Chloxeo/SCALAR-7_CanSat/hardware/Lib_VIF_ELAN/3D/CON_UFL001-SMD-T.stp

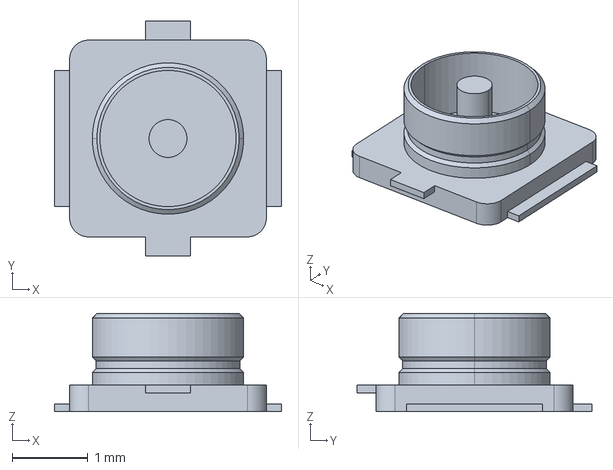
[picture p2: CAD file, 2026-10-30]
hardware/Lib_VIF_ELAN/3D/CON_UFL001-SMD-T.stp
3.00 x 3.10 x 1.30 mm
