Chloxeo/SCALAR-7_CanSat/hardware/Lib_VIF_ELAN/3D/SMA_coude.stp

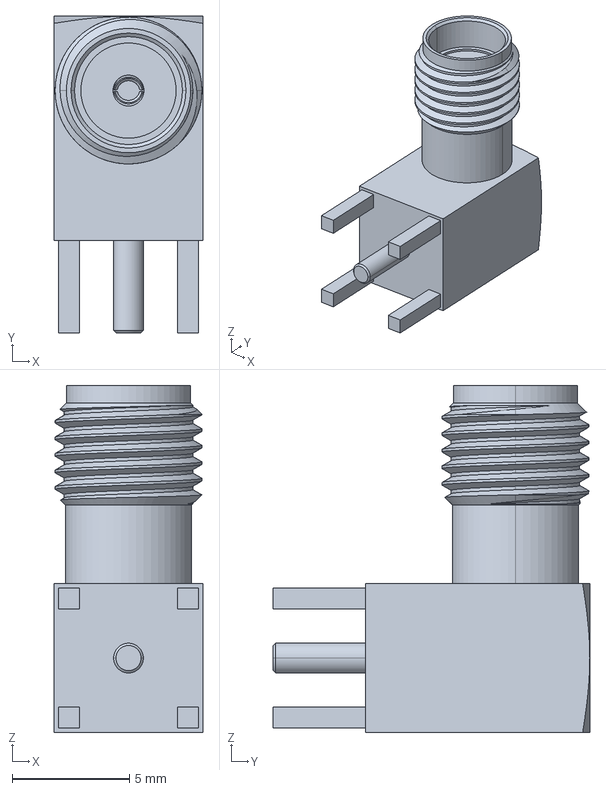
[picture p3: CAD file, 2026-10-30]
hardware/Lib_VIF_ELAN/3D/SMA_coude.stp
6.35 x 13.5 x 14.8 mm
