Chloxeo/SCALAR-7_CanSat/hardware/Lib_VIF_ELAN/3D/pile btn.stp

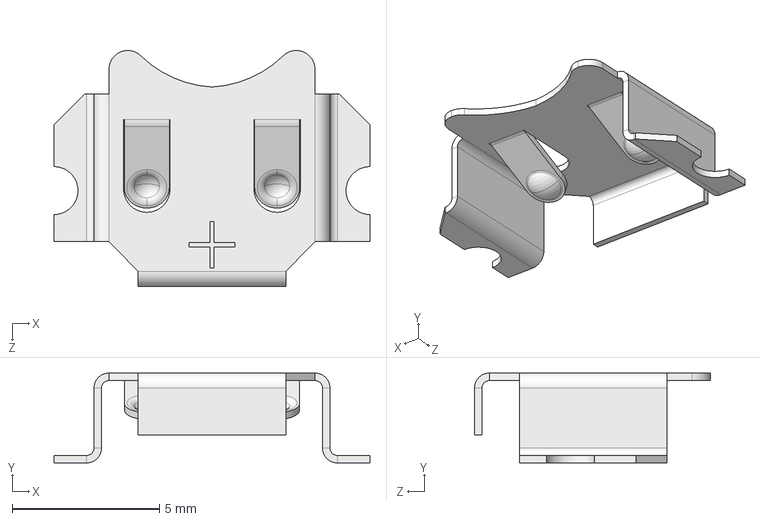
[picture p4: CAD file, 2026-10-30]
hardware/Lib_VIF_ELAN/3D/pile btn.stp
10.7 x 3.05 x 8.00 mm
