Chloxeo/SCALAR-7_CanSat/hardware/Lib_VIF_ELAN/3D/CEM-1206S.STEP

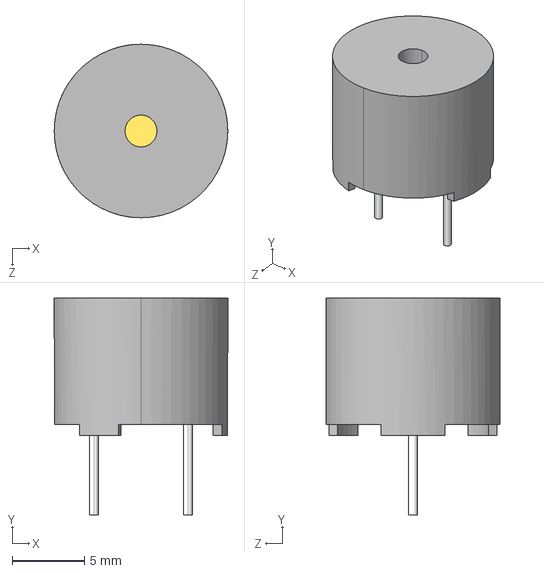
[picture p6: CAD file, 2026-10-30]
hardware/Lib_VIF_ELAN/3D/CEM-1206S.STEP
12.0 x 15.0 x 12.0 mm
