Chloxeo/SCALAR-7_CanSat/hardware/Lib_VIF_ELAN/3D/22-05-3041.stp

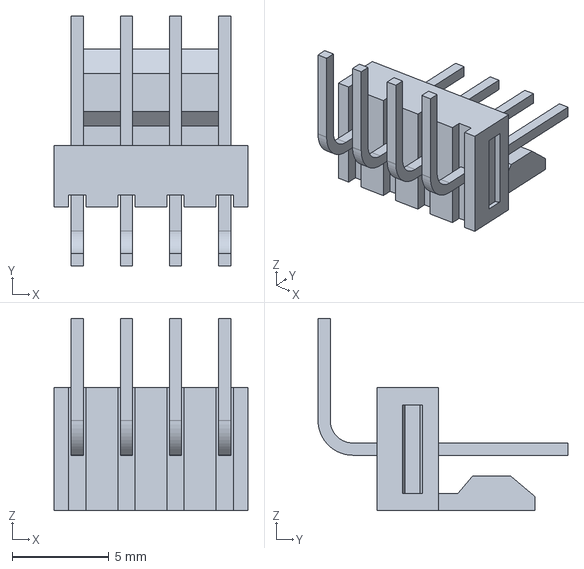
[picture p7: CAD file, 2026-10-30]
hardware/Lib_VIF_ELAN/3D/22-05-3041.stp
10.0 x 12.9 x 9.93 mm
