Chloxeo/SCALAR-7_CanSat/hardware/Lib_VIF_ELAN/3D/USB4085-GF-A.stp

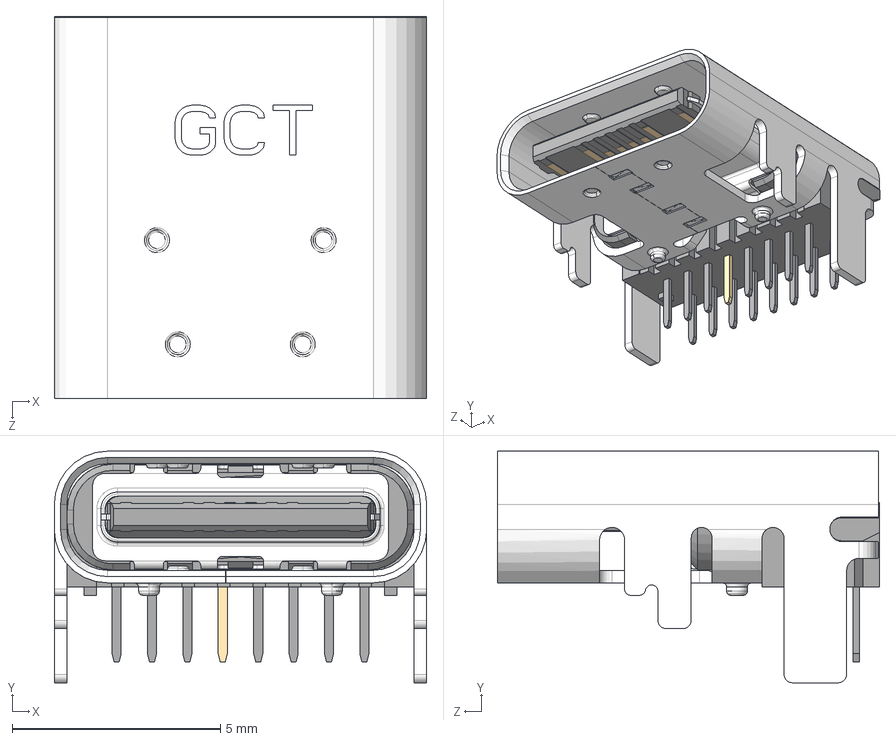
[picture p9: CAD file, 2026-10-30]
hardware/Lib_VIF_ELAN/3D/USB4085-GF-A.stp
8.94 x 5.56 x 9.17 mm
USB4085-GF-A_PART3
USB4085-GF-A_PART2
USB4085-GF-A_PART1
