Chloxeo/SCALAR-7_CanSat/hardware/Lib_VIF_ELAN/3D/KP466PXTMA1.stp

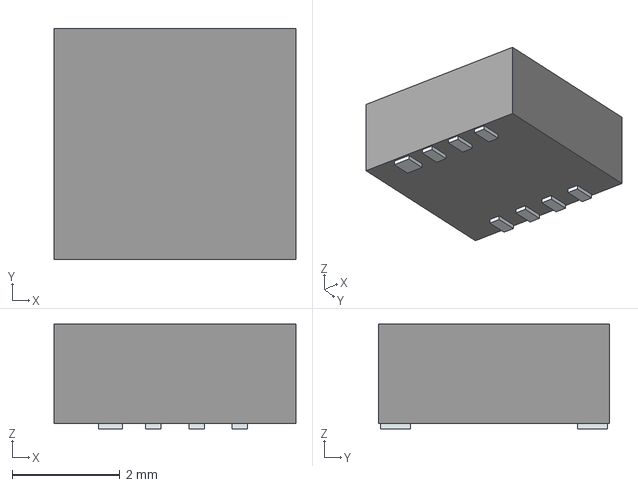
[picture p10: CAD file, 2026-10-30]
hardware/Lib_VIF_ELAN/3D/KP466PXTMA1.stp
4.50 x 4.30 x 1.95 mm
Pins
