Chloxeo/SCALAR-7_CanSat/hardware/Lib_VIF_ELAN/3D/RFM95W-868S2.stp

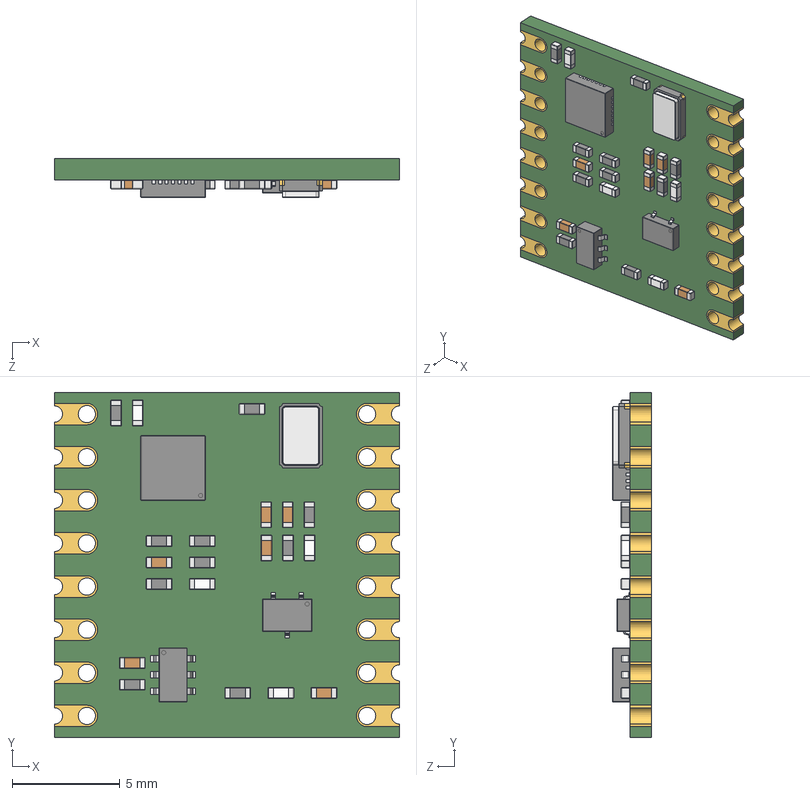
[picture p11: CAD file, 2026-10-30]
hardware/Lib_VIF_ELAN/3D/RFM95W-868S2.stp
16.0 x 16.0 x 1.80 mm
Gold_3
Gold_5
Gold_12
Gold_14
Gold_8
Gold_13
Gold
Gold_7
Gold_6
Gold_15
Gold_11
Gold_16
Gold_10
Gold_2
Gold_9
Gold_4
Passive Pins_22
Passive Pins_38
Passive Pins_30
Passive Pins_21
Passive Pins_10
Passive Pins_4
Passive Pins_35
Passive Pins_29
Passive Pins_28
Passive Pins
Passive Pins_32
Passive Pins_37
Passive Pins_40
Passive Pins_15
Passive Pins_31
Passive Pins_11
Passive Pins_13
Passive Pins_9
Passive Pins_7
Passive Pins_25
Passive Pins_16
Passive Pins_6
Passive Pins_19
Passive Pins_3
Passive Pins_23
Passive Pins_5
Passive Pins_17
Passive Pins_33
Passive Pins_39
Passive Pins_24
Passive Pins_12
Passive Pins_18
Passive Pins_8
Passive Pins_20
Passive Pins_2
Passive Pins_14
Passive Pins_26
Passive Pins_27
Passive Pins_36
Passive Pins_34
White Passive body_3
White Passive body_4
White Passive body_2
White Passive body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
