Chloxeo/SCALAR-7_CanSat/hardware/Lib_VIF_ELAN/3D/BAT54W-G3-18.stp

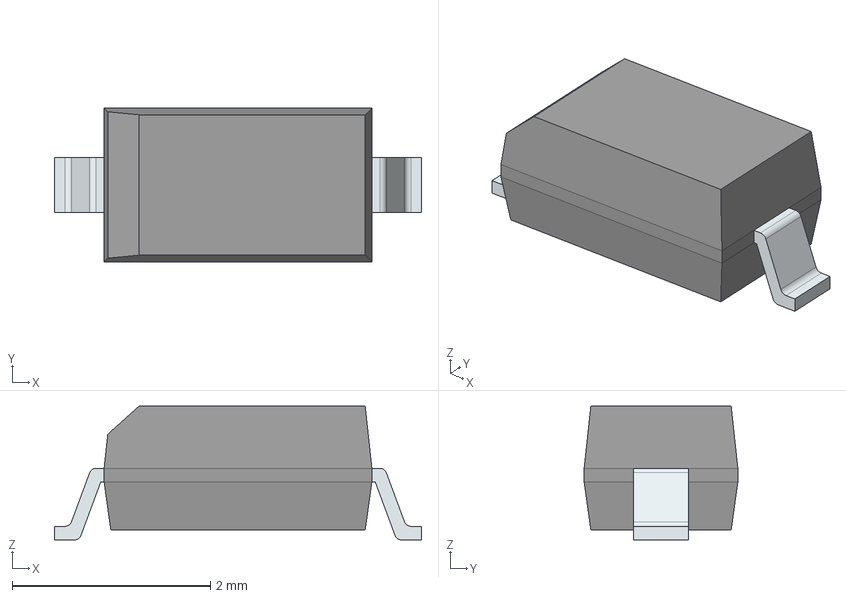
[picture p12: CAD file, 2026-10-30]
hardware/Lib_VIF_ELAN/3D/BAT54W-G3-18.stp
3.70 x 1.55 x 1.35 mm
FilletPinL
FilletPinR
