Chloxeo/SCALAR-7_CanSat/hardware/Lib_VIF_ELAN/3D/53048-0810.stp

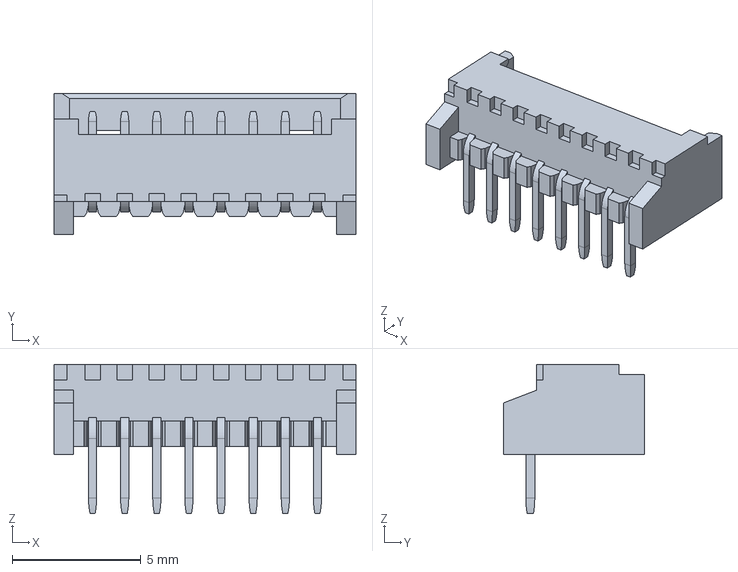
[picture p13: CAD file, 2026-10-30]
hardware/Lib_VIF_ELAN/3D/53048-0810.stp
11.8 x 5.50 x 5.80 mm
