Chloxeo/SCALAR-7_CanSat/schematic.pdf

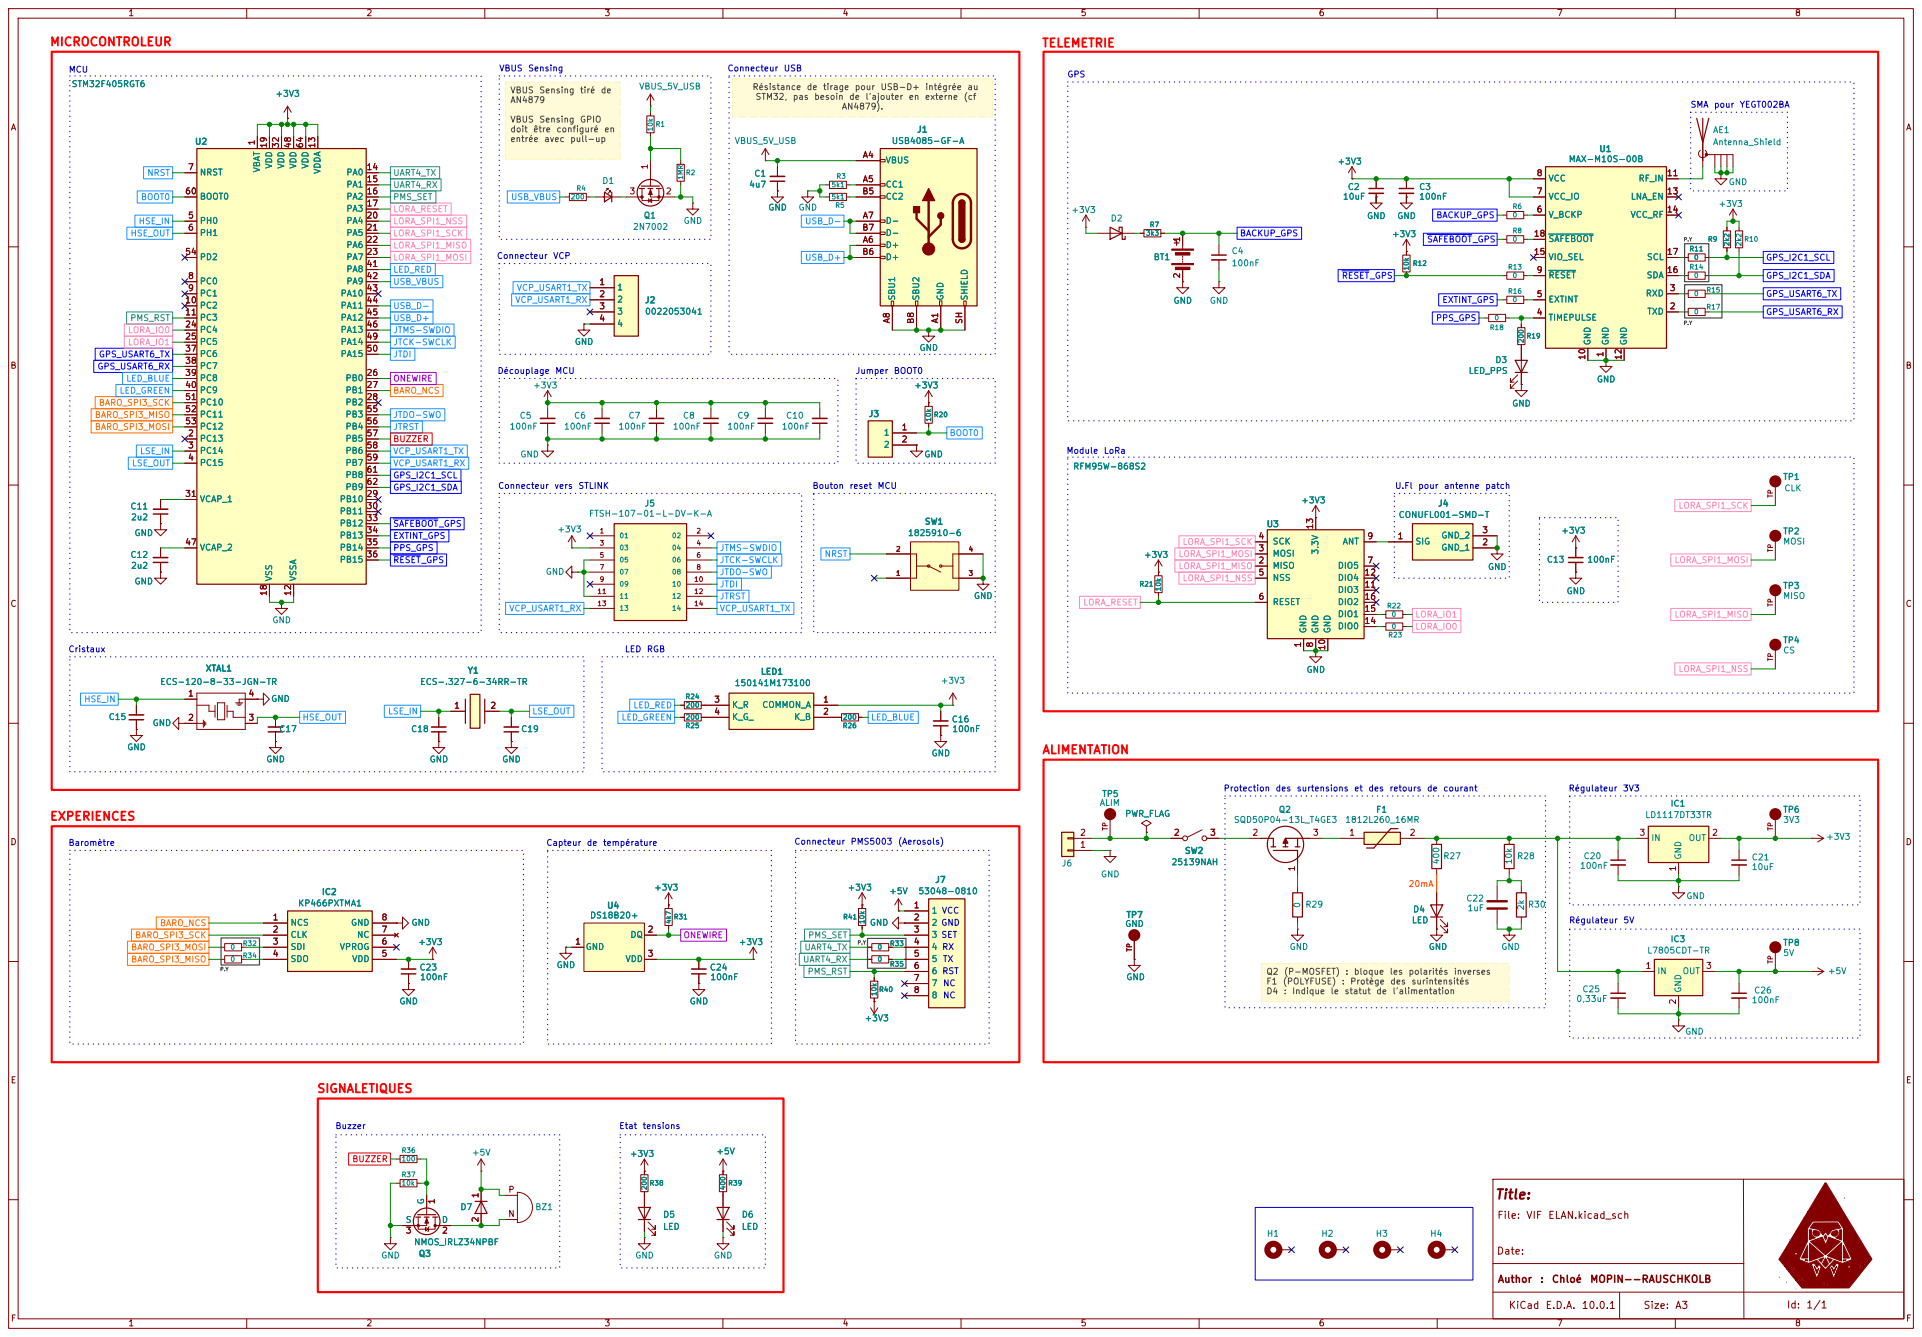
[picture p14: page 1]

Protection des surtensions et des retours de courant Découplage MCU MCU MICROCONTROLEUR

VBUS Sensing tiré de

Résistance de tirage pour USB-D+ intégrée au STM32, pas besoin de l'ajouter en externe (cf AN4879).

VBUS Sensing GPIO
doit être configuré en
entrée avec pull-up

Jumper BOOT0 Bouton reset MCU

Q2 (P-MOSFET) : bloque les polarités inverses F1 (POLYFUSE) : Protège des surintensités D4 : Indique le statut de l'alimentation

Author : Chloé MOPIN--RAUSCHKOLB
