Chloxeo/SCALAR-7_CanSat/hardware/VIF ELAN.kicad_pcb

## KiCad design hardware/VIF ELAN.kicad_pcb (2026-11-06)

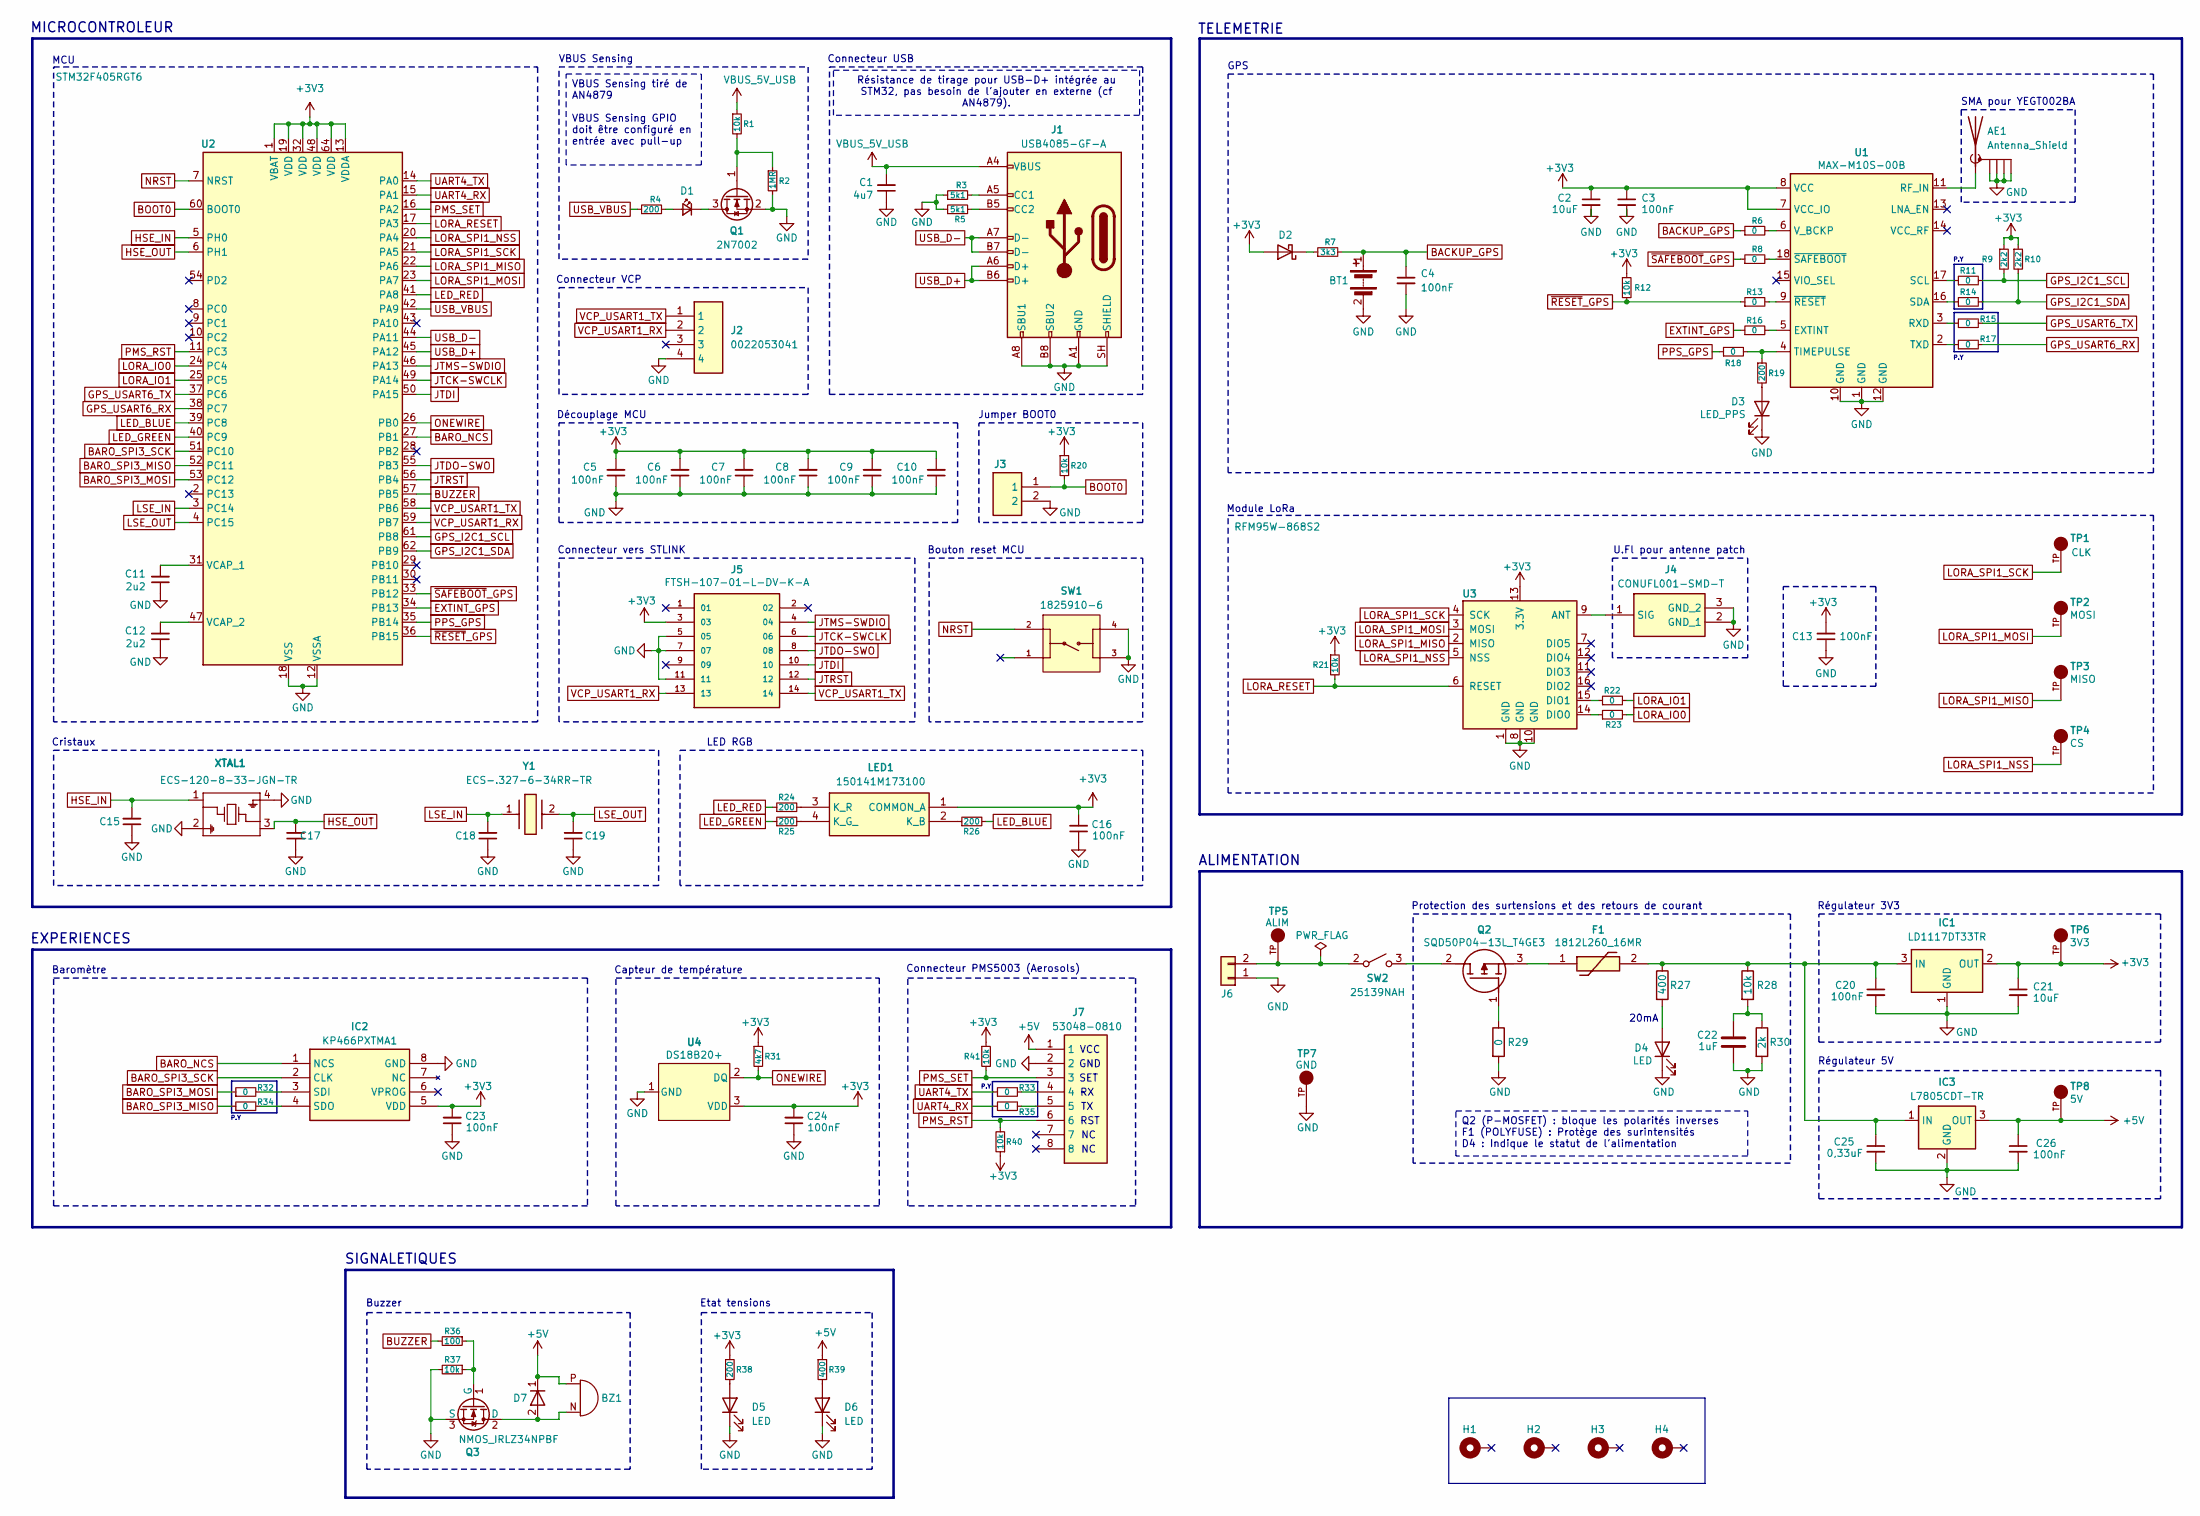
[picture p15: schematic VIF ELAN.kicad_sch]

Parts:
AE1: Antenna_Shield; SMA_coude
BT1: 6.8mm 3.3V; pile btn
BZ1: Buzzer; buzzer CUI_CEM-1206S
C1: 4u7; C_0603_1608Metric_Pad1.08x0.95mm_HandSolder
C2, C21: 10uF; C_0603_1608Metric_Pad1.08x0.95mm_HandSolder
C3, C4, C5, C6, C7, C8, C9, C10, C13, C16, C20, C23, C24, C26: 100nF; C_0603_1608Metric_Pad1.08x0.95mm_HandSolder
C11, C12: 2u2; C_0603_1608Metric_Pad1.08x0.95mm_HandSolder
C15, C17, C18, C19: C_0603_1608Metric_Pad1.08x0.95mm_HandSolder
C22: 1uF; C_0603_1608Metric_Pad1.08x0.95mm_HandSolder
C25: 0,33uF; C_0603_1608Metric_Pad1.08x0.95mm_HandSolder
D1, D4, D5, D6: LED; LED_0805_2012Metric_Pad1.15x1.40mm_HandSolder
D2: bat54 SOD3716X135N
D3: LED_PPS; LED_0805_2012Metric_Pad1.15x1.40mm_HandSolder
D7: D; D_0805_2012Metric_Pad1.15x1.40mm_HandSolder
F1: 1812L260_16MR; 1812L010DR; Mouser Part Number 576-1812L260/16MR
H1, H2, H3, H4: MountingHole_Pad; MountingHole_2.2mm_M2_DIN965_Pad_TopBottom
IC1: LD1117DT33TR; Mouser Part Number 511-LD1117DT33-TR
IC2: KP466PXTMA1; Mouser Part Number 726-KP466PXTMA1
IC3: L7805CDT-TR; L7805CDTTR; Mouser Part Number 511-L7805CDT-TR
J1: USB4085-GF-A; USB_C_Receptacle_GCT_USB4085; Manufacturer_Part_Number USB4085-GF-A
J2: 0022053041; 22053041; Manufacturer_Part_Number 0022053041; Mouser Part Number N/A
J3: TSW-102-07-G-S; jumper TSW-102-XX-YY-S; Manufacturer_Part_Number TSW-102-07-G-S; Mouser Part Number 200-TSW10207GS
J4: CONUFL001-SMD-T; CONUFL001SMDT; Mouser Part Number N/A
J5: FTSH-107-01-L-DV-K-A; FTSH-107-XX-YYY-DV-K-A; PARTREV H
J6: Batterie; SHDR2W100P0X508_1X2_1216X850X1215P
J7: 53048-0810; 530480810; Manufacturer_Part_Number 53048-0810; Mouser Part Number 538-53048-0810
LED1: 150141M173100; LED_RGB_Wuerth-PLCC4_3.2x2.8mm_150141M173100; Manufacturer_Part_Number 150141M173100; Mouser Part Number 710-150141M173100
Q1: 2N7002; SOT-23; Manufacturer_Part_Number DS18B20+
Q2: SQD50P04-13L_T4GE3; Q2 SQD50P0413L_T4GE3; Mouser Part Number 78-SQD50P04-13LT4GE3
Q3: NMOS_IRLZ34NPBF; TO-220-3_Horizontal_TabDown
R1, R12, R20, R21, R28, R37, R40, R41: 10k; R_0603_1608Metric_Pad0.98x0.95mm_HandSolder
R2: 1MR; R_0603_1608Metric_Pad0.98x0.95mm_HandSolder
R3, R5: 5k1; R_0603_1608Metric_Pad0.98x0.95mm_HandSolder
R4, R19, R24, R25, R26, R38: 200; R_0603_1608Metric_Pad0.98x0.95mm_HandSolder
R6, R8, R11, R13, R14, R15, R16, R17, R18, R22, R23, R29, R32, R33, R34, R35: 0; R_0603_1608Metric_Pad0.98x0.95mm_HandSolder
R7: 3k3; R_0603_1608Metric_Pad0.98x0.95mm_HandSolder
R9, R10: 2k2; R_0603_1608Metric_Pad0.98x0.95mm_HandSolder
R27, R39: 400; R_0603_1608Metric_Pad0.98x0.95mm_HandSolder
R30: 2k; R_0603_1608Metric_Pad0.98x0.95mm_HandSolder
R31: 4k7; R_0603_1608Metric_Pad0.98x0.95mm_HandSolder
R36: 100; R_0603_1608Metric_Pad0.98x0.95mm_HandSolder
SW1: 1825910-6; 18259106; PARTREV C10
SW2: 25139NAH
TP1: CLK; 5003; PARTREV B
TP2: MOSI; 5003; PARTREV B
TP3: MISO; 5003; PARTREV B
TP4: CS; 5003; PARTREV B
TP5: ALIM; 5003; PARTREV B
TP6: 3V3; 5003; PARTREV B
TP7: GND; 5003; PARTREV B
TP8: 5V; 5003; PARTREV B
U1: MAX-M10S-00B; ublox_MAX
U2: STM32F405RGT6; LQFP-64_10x10mm_P0.5mm; Manufacturer_Part_Number STM32F405RGT6
U3: RFM95W-868S2; HOPERF_RFM9XW_SMD; Manufacturer_Part_Number RFM95W-868S2
U4: DS18B20+; temp 21-0248A_MXM; Manufacturer_Part_Number DS18B20+
XTAL1: ECS-120-8-33-JGN-TR; ECS-120-8-33-JGN-TR_ECS; Manufacturer_Part_Number ECS-120-8-33-JGN-TR
Y1: ECS-.327-6-34RR-TR; ECS32712534RRTR; Manufacturer_Part_Number ECS-.327-6-34RR-TR; Mouser Part Number 520-.327-6-34RRT

Connections:
+3V3: C2.1, C3.1, C5.2, C6.2, C7.2, C8.2, C9.2, C10.2, C13.2, C16.2, C21.1, C23.2, C24.2, D2.2 (A), IC1.2 (OUT), IC2.5 (VDD), J5.3, LED1.1 (COMMON_A), R9.1, R10.1, R12.1, R20.1, R21.1, R31.1, R38.1, R40.1, R41.1, TP6.TP, U1.7 (VCC_IO), U1.8 (VCC), U2.1 (VBAT), U2.13 (VDDA), U2.19 (VDD), U2.32 (VDD), U2.48 (VDD), U2.64 (VDD), U3.13 (3.3V), U4.3 (VDD)
+5V: BZ1.P (-), C26.1, D7.1 (K), IC3.3 (OUT), J7.1, R39.1, TP8.TP
BACKUP_GPS: BT1.1 (+), C4.1, R6.1, R7.2
BARO_NCS: IC2.1 (NCS), U2.27 (PB1)
BARO_SPI3_MISO: R34.1, U2.52 (PC11)
BARO_SPI3_MOSI: R32.1, U2.53 (PC12)
BARO_SPI3_SCK: IC2.2 (CLK), U2.51 (PC10)
BOOT0: J3.1, R20.2, U2.60 (BOOT0)
BUZZER: R36.2, U2.57 (PB5)
EXTINT_GPS: R16.1, U2.34 (PB13)
GND: AE1.2 (GND), AE1.3 (GND), AE1.4 (GND), AE1.5 (GND), BT1.2 (-), C1.1, C2.2, C3.2, C4.2, C5.1, C6.1, C7.1, C8.1, C9.1, C10.1, C11.1, C12.1, C13.1, C15.1, C16.1, C17.1, C18.1, C19.1, C20.2, C21.2, C22.2, C23.1, C24.1, C25.2, C26.2, D3.1 (K), D4.1 (K), D5.1 (K), D6.1 (K), IC1.1 (GND), IC2.8 (GND), IC3.2 (GND), J1.A1 (GND), J1.A8 (SBU1), J1.B8 (SBU2), J1.SH (SHIELD), J2.4, J3.2, J4.2 (GND_1), J4.3 (GND_2), J5.5, J5.7, J5.11, J6.1, J7.2, Q1.2 (S), Q3.3 (S), R2.2, R3.1, R5.1, R29.2, R30.2, R37.2, SW1.1, SW1.3, SW1.4, TP7.TP, U1.1 (GND), U1.10 (GND), U1.12 (GND), U2.12 (VSSA), U2.18 (VSS), U3.1 (GND), U3.8 (GND), U3.10 (GND), U4.1 (GND), XTAL1.2, XTAL1.4; also elsewhere on the board
GPS_I2C1_SCL: R9.2, R11.2, U2.61 (PB8)
GPS_I2C1_SDA: R10.2, R14.2, U2.62 (PB9)
GPS_USART6_RX: R17.2, U2.38 (PC7)
GPS_USART6_TX: R15.2, U2.37 (PC6)
HSE_IN: C15.2, U2.5 (PH0), XTAL1.1
HSE_OUT: C17.2, U2.6 (PH1), XTAL1.3
JTCK-SWCLK: J5.6, U2.49 (PA14)
JTDI: J5.10, U2.50 (PA15)
JTDO-SWO: J5.8, U2.55 (PB3)
JTMS-SWDIO: J5.4, U2.46 (PA13)
JTRST: J5.12, U2.56 (PB4)
LED_BLUE: R26.2, U2.39 (PC8)
LED_GREEN: R25.1, U2.40 (PC9)
LED_RED: R24.1, U2.41 (PA8)
LORA_IO0: R23.2, U2.24 (PC4)
LORA_IO1: R22.2, U2.25 (PC5)
LORA_RESET: R21.2, U2.17 (PA3), U3.6 (RESET)
LORA_SPI1_MISO: TP3.TP, U2.22 (PA6), U3.2 (MISO)
LORA_SPI1_MOSI: TP2.TP, U2.23 (PA7), U3.3 (MOSI)
LORA_SPI1_NSS: TP4.TP, U2.20 (PA4), U3.5 (NSS)
LORA_SPI1_SCK: TP1.TP, U2.21 (PA5), U3.4 (SCK)
LSE_IN: C18.2, U2.3 (PC14), Y1.1
LSE_OUT: C19.2, U2.4 (PC15), Y1.2
NRST: SW1.2, U2.7 (NRST); also elsewhere on the board
unnamed: AE1.1 (A), U1.11 (RF_IN)
unnamed: BZ1.N (+), D7.2 (A), Q3.2 (D)
unnamed: C22.1, R28.2, R30.1
unnamed: D1.2 (A), R4.2
unnamed: D1.1 (K), Q1.3 (D)
unnamed: D2.1 (K), R7.1
unnamed: D3.2 (A), R19.2
unnamed: D4.2 (A), R27.2
unnamed: D5.2 (A), R38.2
unnamed: D6.2 (A), R39.2
unnamed: C20.1, C25.1, F1.2, IC1.3 (IN), IC3.1 (IN), R27.1, R28.1
unnamed: IC2.3 (SDI), R32.2
unnamed: IC2.4 (SDO), R34.2
unnamed: J1.A5 (CC1), R3.2
unnamed: J1.B5 (CC2), R5.2
unnamed: J4.1 (SIG), U3.9 (ANT)
unnamed: J6.2, SW2.2 (A), TP5.TP
unnamed: J7.4, R33.2
unnamed: J7.5, R35.2
unnamed: LED1.2 (K_B), R26.1
unnamed: LED1.4 (K_G_), R25.2
unnamed: LED1.3 (K_R), R24.2
unnamed: Q1.1 (G), R1.2, R2.1
unnamed: Q2.2 (D), SW2.3 (B)
unnamed: Q2.1 (G), R29.1
unnamed: F1.1, Q2.3 (S)
unnamed: Q3.1 (G), R36.1, R37.1
unnamed: R16.2, U1.5 (EXTINT)
unnamed: R15.1, U1.3 (RXD)
unnamed: R11.1, U1.17 (SCL)
unnamed: R14.1, U1.16 (SDA)
unnamed: R18.2, R19.1, U1.4 (TIMEPULSE)
unnamed: R17.1, U1.2 (TXD)
unnamed: R6.2, U1.6 (V_BCKP)
unnamed: R13.2, U1.9 (~RESET)
unnamed: R8.2, U1.18 (~SAFEBOOT)
unnamed: C11.2, U2.31 (VCAP_1)
unnamed: C12.2, U2.47 (VCAP_2)
unnamed: R23.1, U3.14 (DIO0)
unnamed: R22.1, U3.15 (DIO1)
ONEWIRE: R31.2, U2.26 (PB0), U4.2 (DQ)
PMS_RST: J7.6, R40.2, U2.11 (PC3)
PMS_SET: J7.3, R41.2, U2.16 (PA2)
PPS_GPS: R18.1, U2.35 (PB14)
UART4_RX: R35.1, U2.15 (PA1)
UART4_TX: R33.1, U2.14 (PA0)
USB_D+: J1.A6 (D+), J1.B6 (D+), U2.45 (PA12)
USB_D-: J1.A7 (D-), J1.B7 (D-), U2.44 (PA11)
USB_VBUS: R4.1, U2.42 (PA9)
VBUS_5V_USB: C1.2, J1.A4 (VBUS), R1.1
VCP_USART1_RX: J2.2, J5.13, U2.59 (PB7)
VCP_USART1_TX: J2.1, J5.14, U2.58 (PB6)
~RESET_GPS: R12.2, R13.1, U2.36 (PB15)
~SAFEBOOT_GPS: R8.1, U2.33 (PB12)

Notes on the sheet:
Découplage MCU
P.Y
SMA pour YEGT002BA
Etat tensions
VCC
Baromètre
TELEMETRIE
GND
Régulateur 5V
Module LoRa
Régulateur 3V3
GPS
Protection des surtensions et des retours de courant
Cristaux
Connecteur PMS5003 (Aerosols)
Jumper BOOT0
U.Fl pour antenne patch
LED RGB
Connecteur USB
Buzzer
SET
Capteur de température
EXPERIENCES
MCU
MICROCONTROLEUR
Connecteur VCP
Bouton reset MCU
ALIMENTATION
SIGNALETIQUES
20mA
VBUS Sensing
Connecteur vers STLINK
RST
VBUS Sensing tiré de AN4879 VBUS Sensing GPIO doit être configuré en entrée avec pull-up
Q2 (P-MOSFET) : bloque les polarités inverses F1 (POLYFUSE) : Protège des surintensités D4 : Indique le statut de l'alimentation
Résistance de tirage pour USB-D+ intégrée au STM32, pas besoin de l'ajouter en externe (cf AN4879).

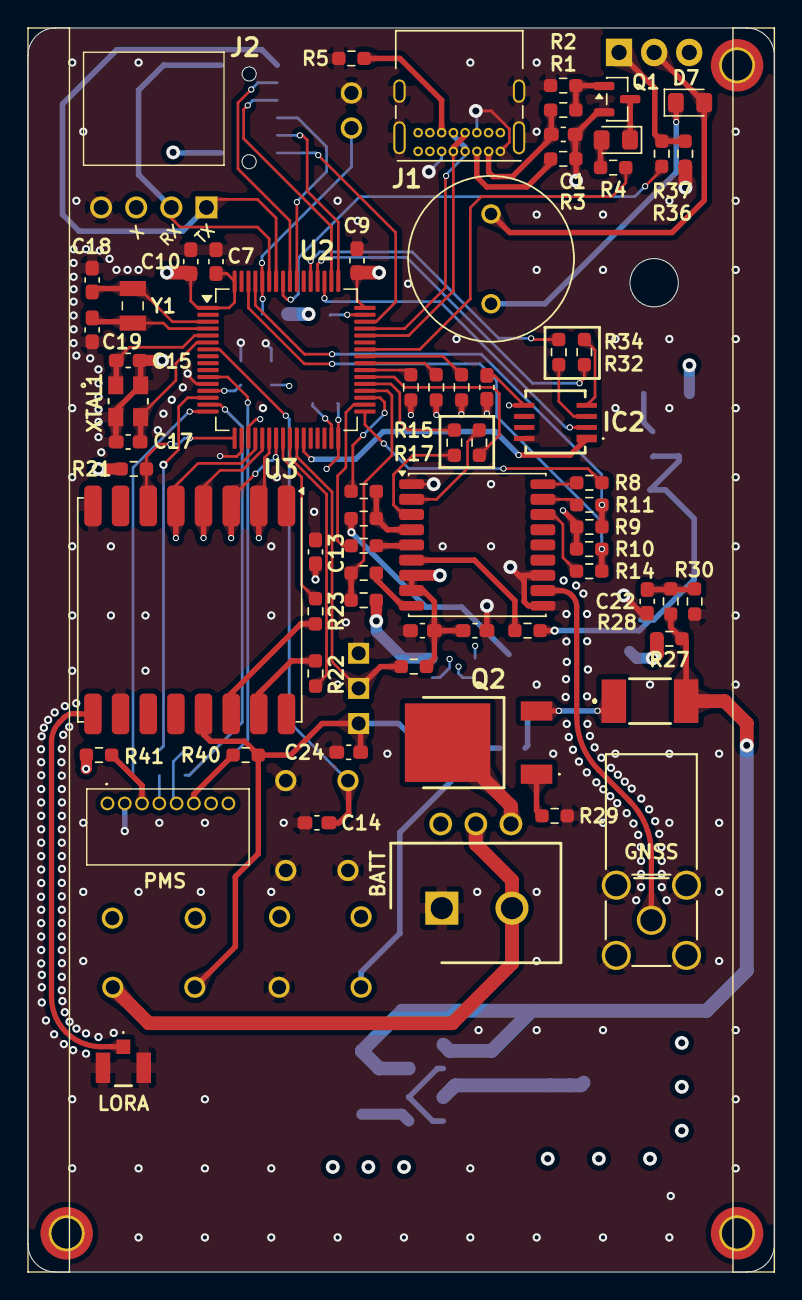
[picture p16: board VIF ELAN.kicad_pcb from above]

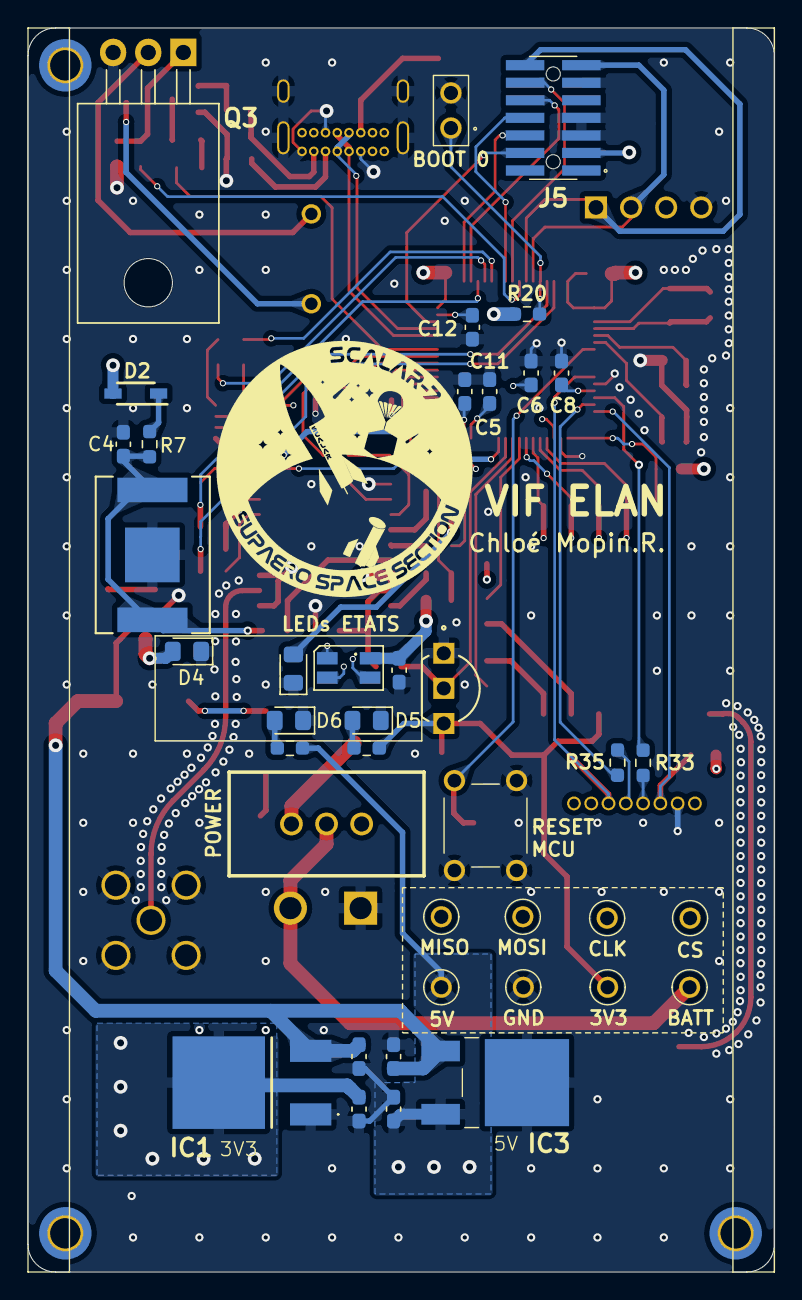
[picture p17: board VIF ELAN.kicad_pcb from below]

Board: 4 copper layers, 54.0 x 90.0 mm, 112 parts (40 on the bottom side), 89 nets.

Other parts of the board:
C14: 100nF; C_0603_1608Metric_Pad1.08x0.95mm_HandSolder
PMS: TestPoint_Pad_1.0x1.0mm

Their connections:
GND: C14.1; also elsewhere on the board
NRST: C14.2; also elsewhere on the board
